SamuelNoesslboeck/DrRo-III/documentation/images/2026_06__04__open_mechanism.jpeg

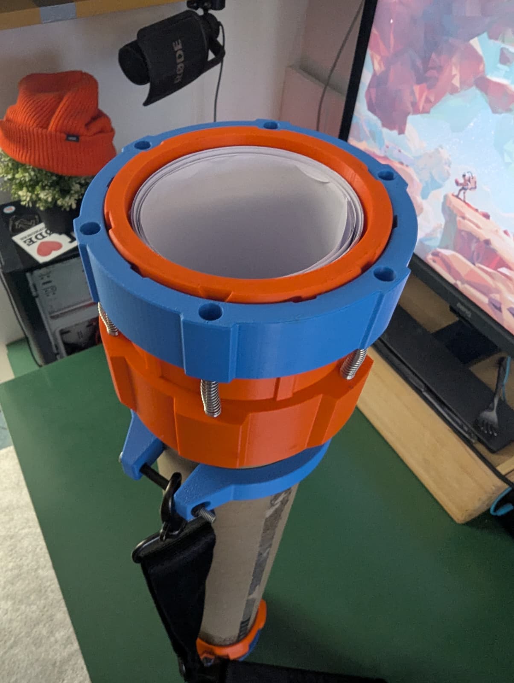
documentation/images/2026_06__04__open_mechanism.jpeg
