SamuelNoesslboeck/DrRo-III/a__drro_iii.SLDASM

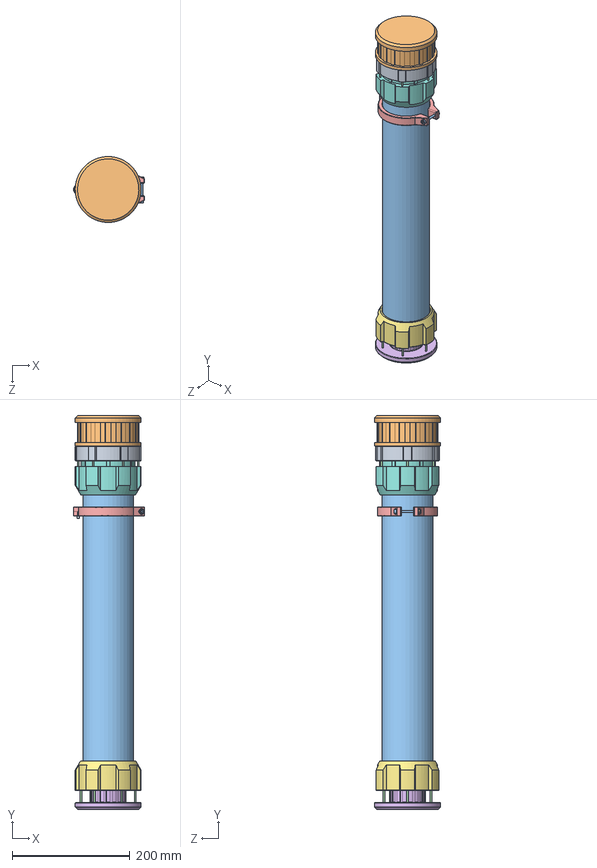
[picture p5: CAD file, 2026-06-12]
a__drro_iii.SLDASM
120.8 x 669.0 x 112.0 mm
m1__cardboard_roll
1__top_lid
2__springed_ring
3__top_connector
4__bottom_connector
5__bottom_lid
6__mounting_ring x 2
n1__din912_m3x30 x 12
n2__din912_m4x40
n4__din934_m4 x 2
n3__din912_m4x16
