SamuelNoesslboeck/DrRo-III/6__mounting_ring.SLDPRT

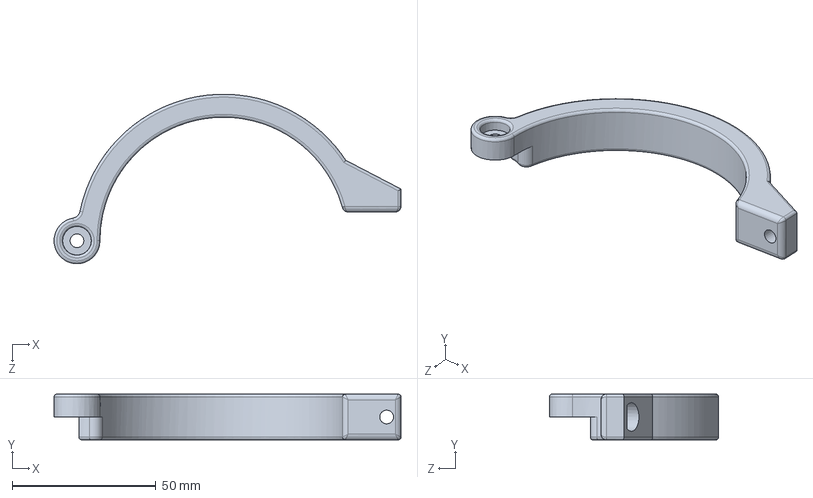
[picture p6: CAD file, 2026-06-12]
6__mounting_ring.SLDPRT
120.8 x 16.0 x 59.0 mm
