SamuelNoesslboeck/DrRo-III/m_modified/m1__cardboard_roll.SLDPRT

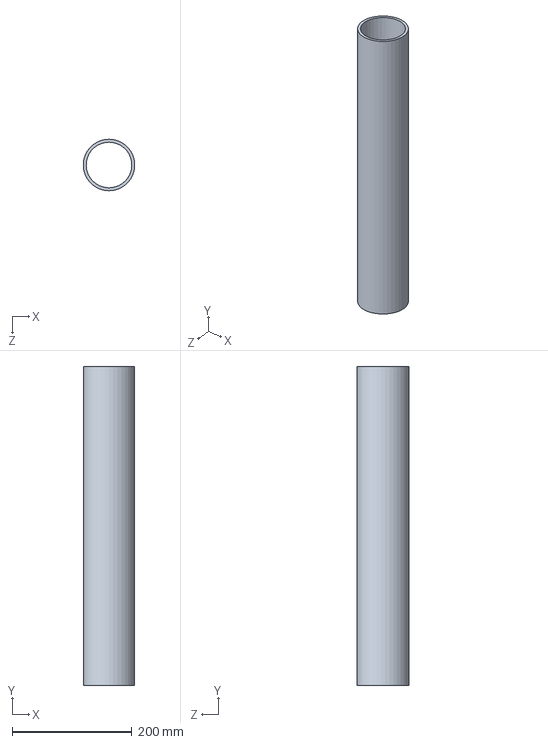
[picture p7: CAD file, 2026-06-12]
m_modified/m1__cardboard_roll.SLDPRT
85.7 x 532.0 x 86.0 mm
