SamuelNoesslboeck/DrRo-III/n_standard/n2__din912_m4x40.SLDPRT

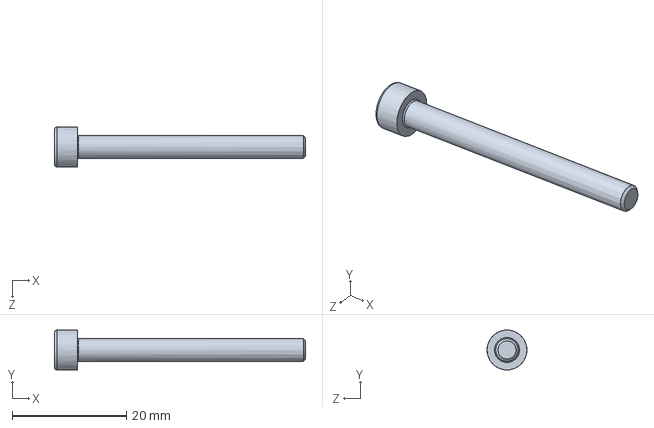
[picture p8: CAD file, 2026-09-18]
n_standard/n2__din912_m4x40.SLDPRT
44.0 x 7.00 x 7.00 mm
