SamuelNoesslboeck/DrRo-III/5__bottom_lid.SLDPRT

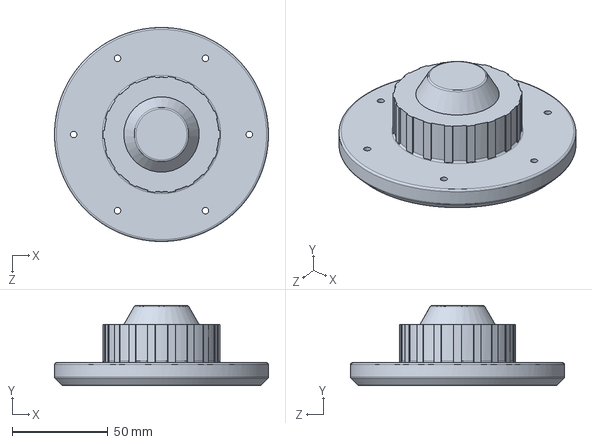
[picture p9: CAD file, 2026-06-12]
5__bottom_lid.SLDPRT
112.0 x 42.0 x 112.0 mm
