SamuelNoesslboeck/DrRo-III/n_standard/n4__din934_m4.SLDPRT

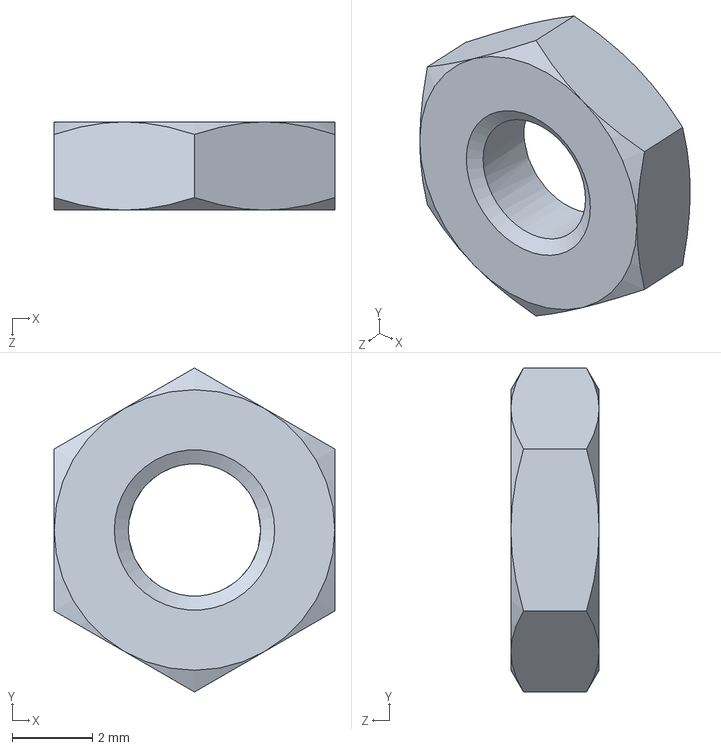
[picture p10: CAD file, 2026-09-18]
n_standard/n4__din934_m4.SLDPRT
7.00 x 8.08 x 2.20 mm
