SamuelNoesslboeck/DrRo-III/n_standard/n3__din912_m4x16.SLDPRT

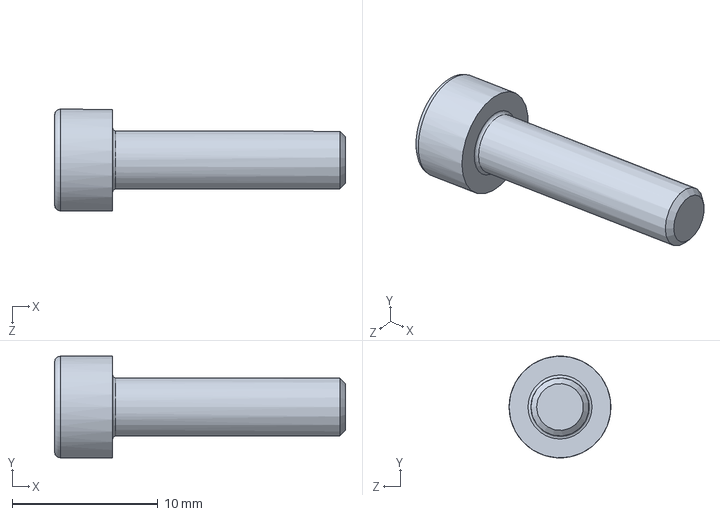
[picture p11: CAD file, 2026-09-18]
n_standard/n3__din912_m4x16.SLDPRT
20.0 x 6.99 x 7.00 mm
