SamuelNoesslboeck/DrRo-III/3__top_connector.SLDPRT

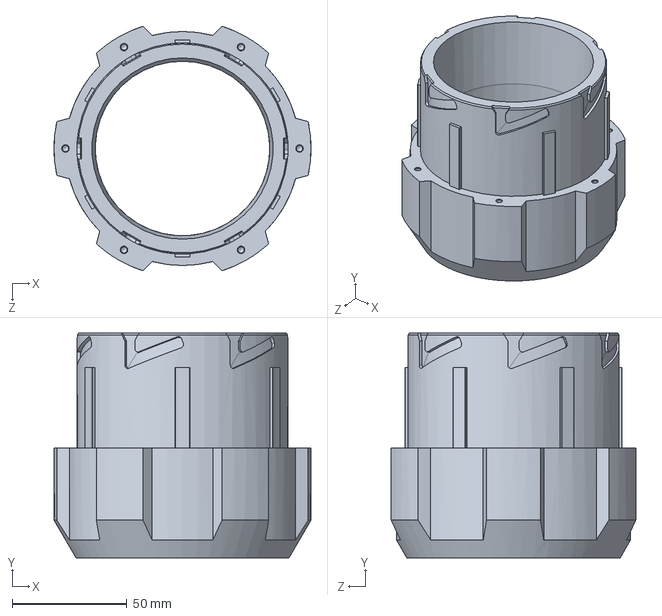
[picture p12: CAD file, 2026-06-12]
3__top_connector.SLDPRT
112.0 x 98.0 x 106.6 mm
