SamuelNoesslboeck/DrRo-III/n_standard/n1__din912_m3x30.SLDPRT

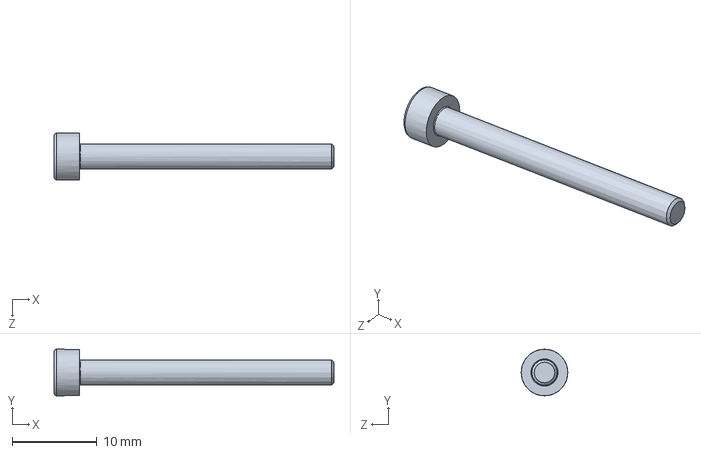
[picture p13: CAD file, 2026-09-18]
n_standard/n1__din912_m3x30.SLDPRT
33.0 x 5.50 x 5.50 mm
