SamuelNoesslboeck/DrRo-III/1__top_lid.SLDPRT

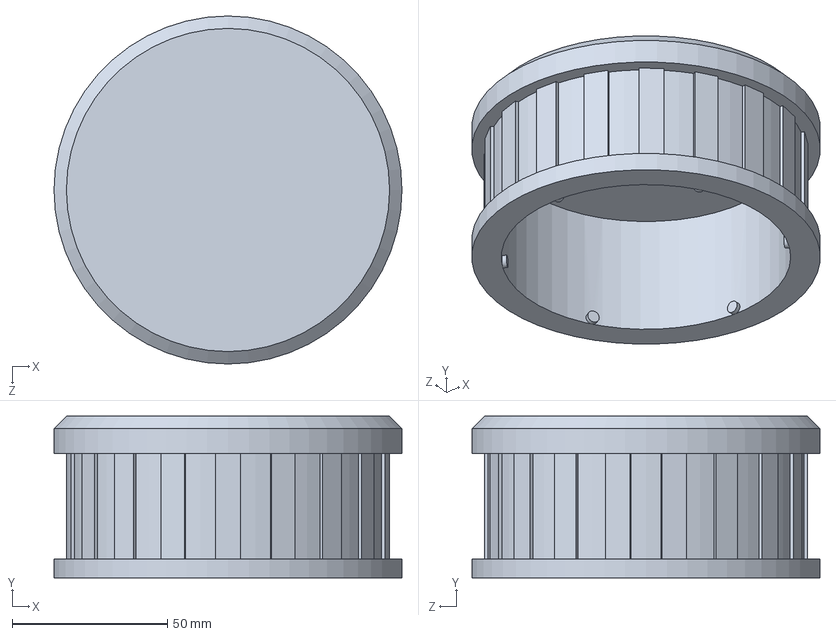
[picture p14: CAD file, 2026-06-12]
1__top_lid.SLDPRT
112.0 x 52.0 x 112.0 mm
