SamuelNoesslboeck/DrRo-III/2__springed_ring.SLDPRT

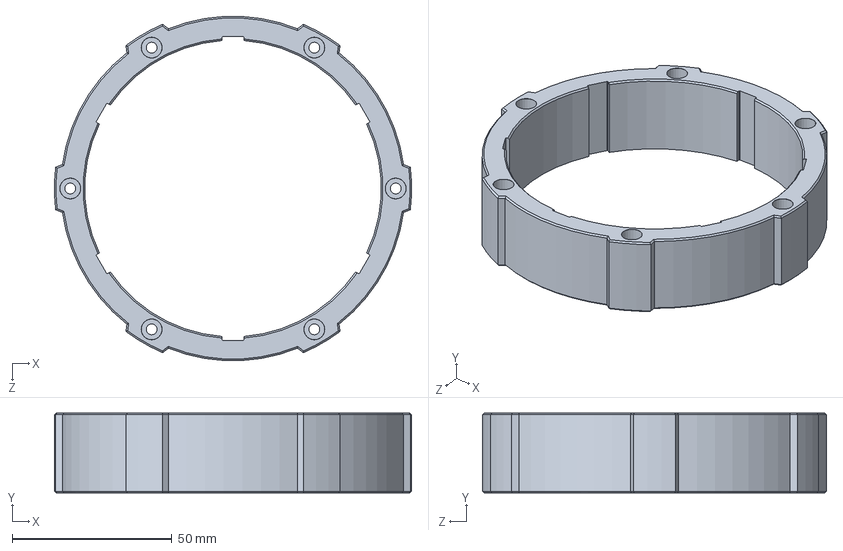
[picture p15: CAD file, 2026-06-12]
2__springed_ring.SLDPRT
111.9 x 25.0 x 107.8 mm
