SamuelNoesslboeck/DrRo-III/4__bottom_connector.SLDPRT

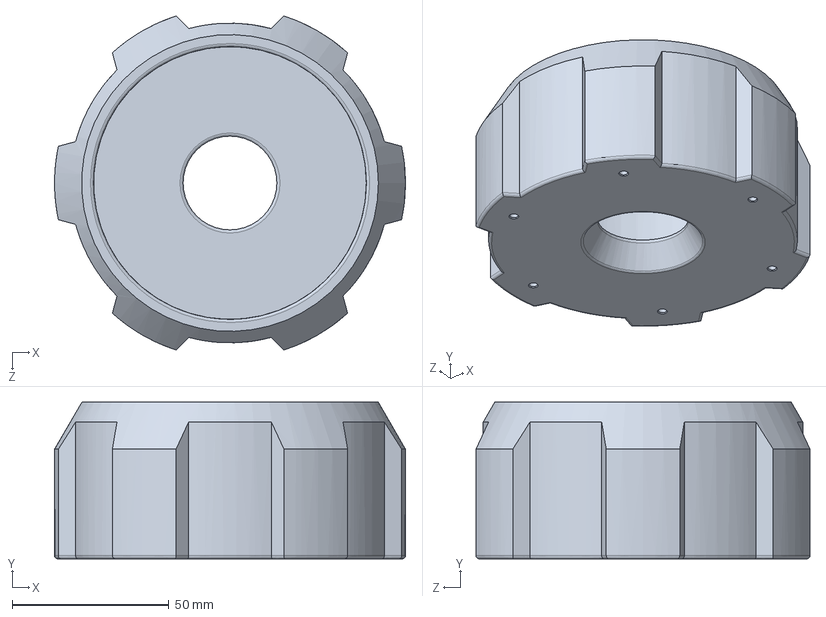
[picture p16: CAD file, 2026-06-12]
4__bottom_connector.SLDPRT
112.0 x 50.0 x 106.6 mm
