SamuelNoesslboeck/DrRo-III/(list of files, cad)

Other CAD files:
a__drro_iii.SLDDRW
printing/1__top_lid.STL
printing/2__springed_ring.STL
printing/3__top_connector.STL
printing/4__bottom_connector.STL
printing/5__bottom_lid.STL
printing/6__mounting_ring.STL
printing/a__drro_iii.3mf
