SamuelNoesslboeck/DrRo-III/export/a__drro_iii.pdf

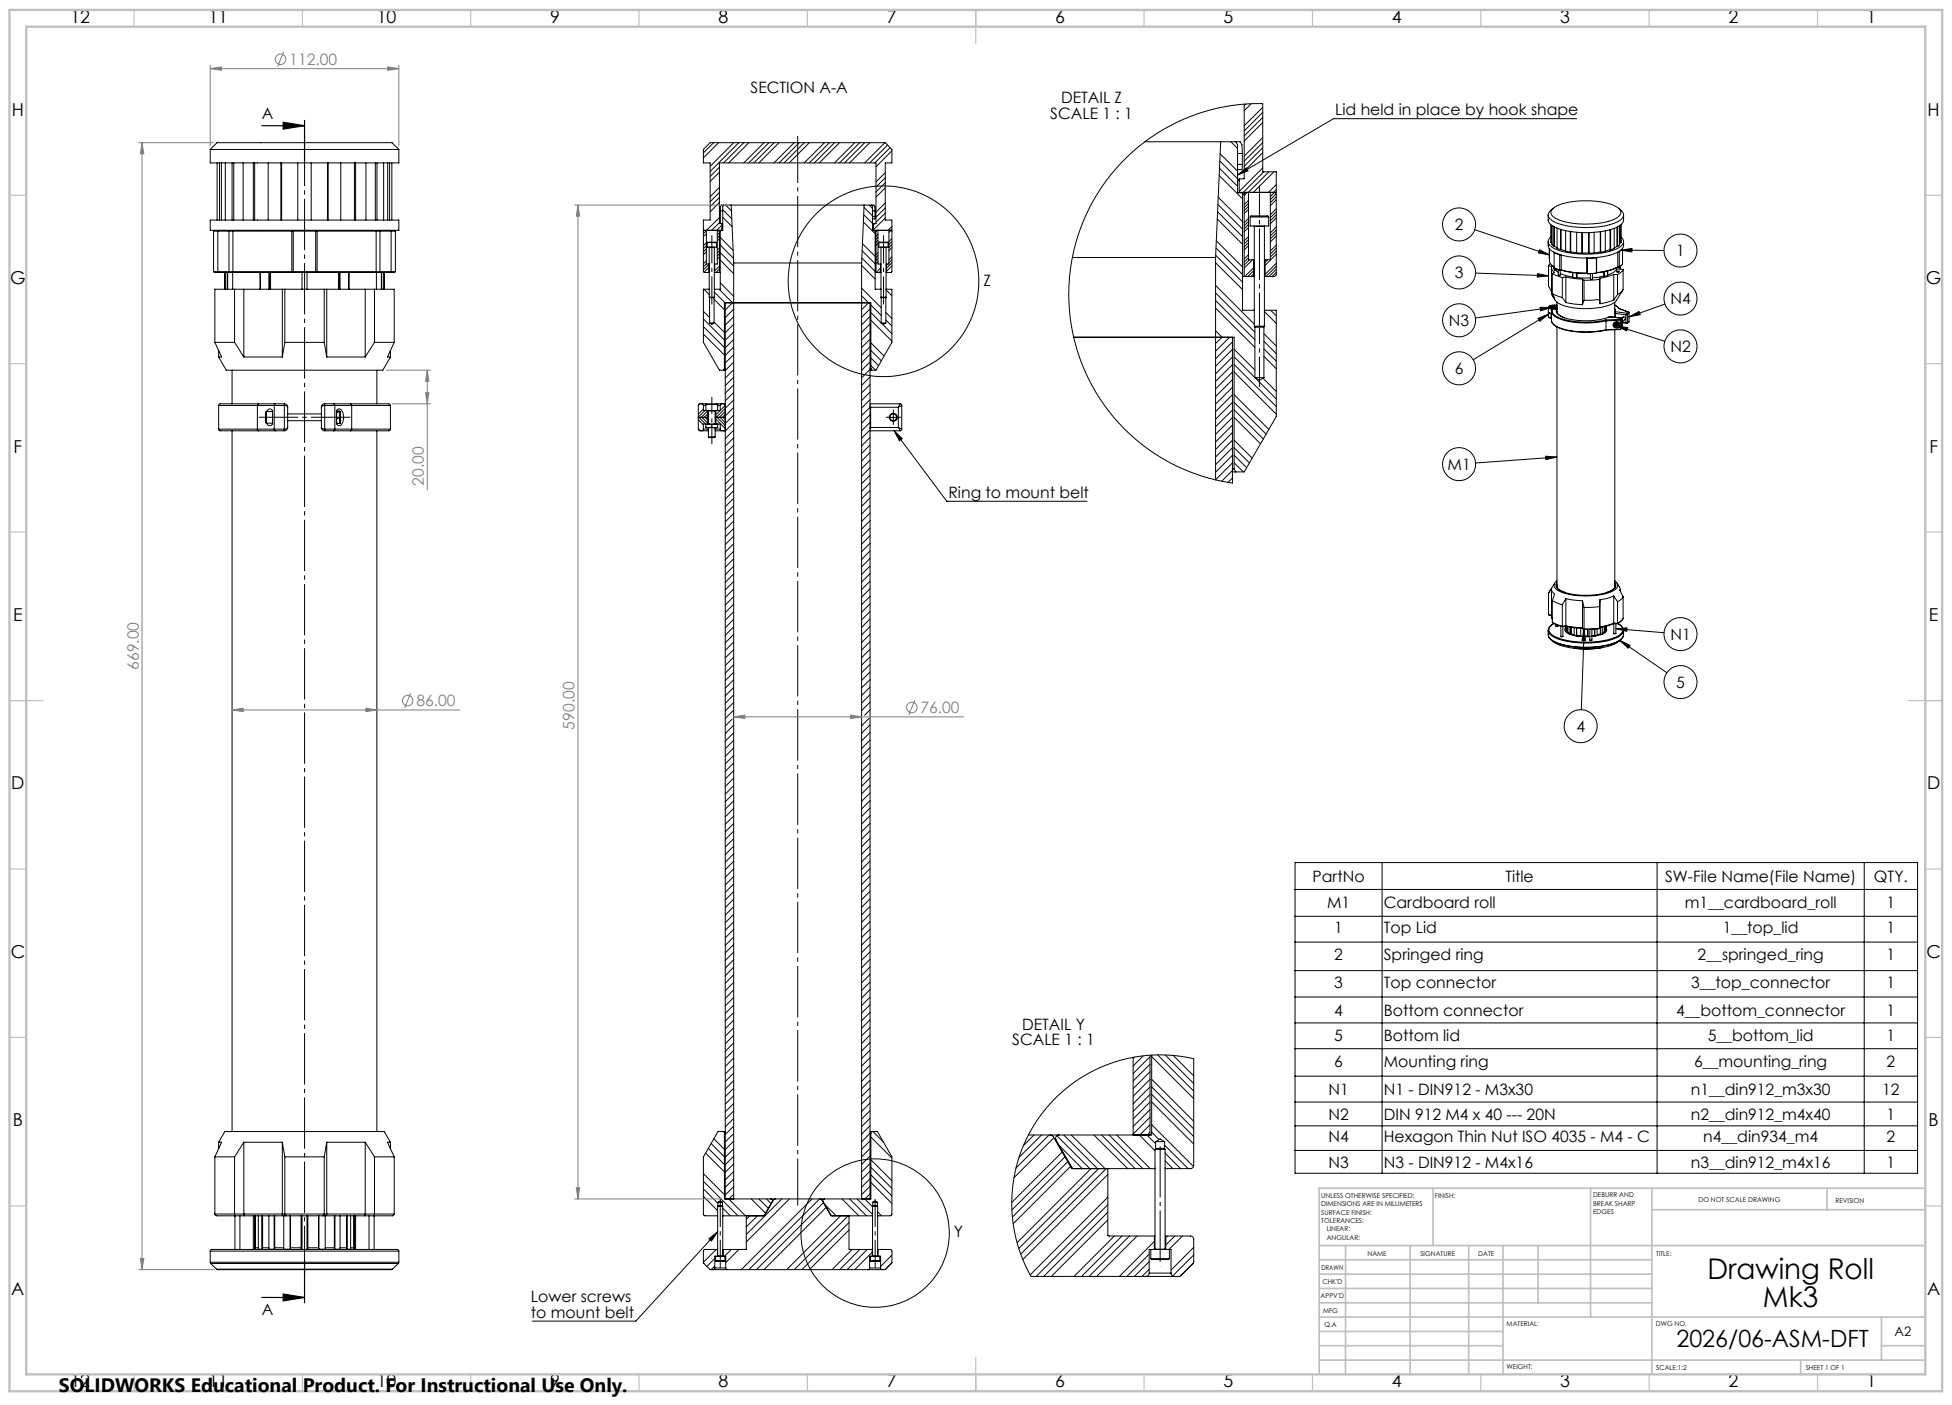
[picture p17: page 1]
SECTION A-A; DETAIL Z; SCALE 1 : 1; Lid held in place by hook shape; DETAIL Y SCALE 1 : 1; FINISH:; DEBURR AND; BREAK SHARP; DO NOT SCALE DRAWING; REVISION; SCALE:1:2; SHEET 1 OF 1

Ring to mount belt

PartNo | Title | SW-File Name(File Name) | QTY.
M1 | Cardboard roll | m1__cardboard_roll | 1
1 | Top Lid | 1__top_lid | 1
2 | Springed ring | 2__springed_ring | 1
3 | Top connector | 3__top_connector | 1
4 | Bottom connector | 4__bottom_connector | 1
5 | Bottom lid | 5__bottom_lid | 1
6 | Mounting ring | 6__mounting_ring | 2
N1 | N1 - DIN912 - M3x30 | n1__din912_m3x30 | 12
N2 | DIN 912 M4 x 40 --- 20N | n2__din912_m4x40 | 1
N4 | Hexagon Thin Nut ISO 4035 - M4 - C | n4__din934_m4 | 2
N3 | N3 - DIN912 - M4x16 | n3__din912_m4x16 | 1

UNLESS OTHERWISE SPECIFIED:
DIMENSIONS ARE IN MILLIMETERS
SURFACE FINISH:
TOLERANCES:
LINEAR:
ANGULAR:

NAME | SIGNATURE | DATE | | | | TITLE: Drawing Roll

DRAWN
CHK'D
APPV'D
MFG
Q.A | | | | MATERIAL: | DWG NO. 2026/06-ASM-DFT | A2

Lower screws
to mount belt

SOLIDWORKS Educational Product. For Instructional Use Only.
