SamuelNoesslboeck/DrRo-III/(commit log)

2026-06-04 basic outline
    [1_top_cap.SLDPRT, 2_springed_ring.SLDPRT, a_drro_iii.SLDASM, m1_cardboard_roll.SLDPRT]
2026-06-06 first draft of project
    [1__top_lid.SLDPRT, 1_top_cap.SLDPRT, 2__springed_ring.SLDPRT, 2_springed_ring.SLDPRT, 3__top_connector.SLDPRT, 4__bottom_connector.SLDPRT, 5__bottom_lid.SLDPRT, a__drro_iii.SLDASM]
2026-06-08 finished cad
    [1__top_lid.SLDPRT, 1__top_lid.STL, 2__springed_ring.SLDPRT, 2__springed_ring.STL, 3__top_connector.SLDPRT, 3__top_connector.STL, 4__bottom_connector.SLDPRT, 4__bottom_connector.STL]
2026-06-08 small additions
    [6__mounting_ring.SLDPRT]
2026-06-12 finishing cad and start of assembly draft
    [1__top_lid.SLDPRT, 2__springed_ring.SLDPRT, 3__top_connector.SLDPRT, 4__bottom_connector.SLDPRT, 5__bottom_lid.SLDPRT, 6__mounting_ring.SLDPRT, a__drro_iii.SLDASM, a__drro_iii.SLDDRW]
2026-09-18 mk3.0.0 - documentation finish
    [a__drro_iii.SLDDRW, n1__din912_m3x30.SLDPRT, n2__din912_m4x40.SLDPRT, n3__din912_m4x16.SLDPRT, n4__din934_m4.SLDPRT]
